av500/bbb_d300_cnc/hardware/bbb_d300_breakout.png

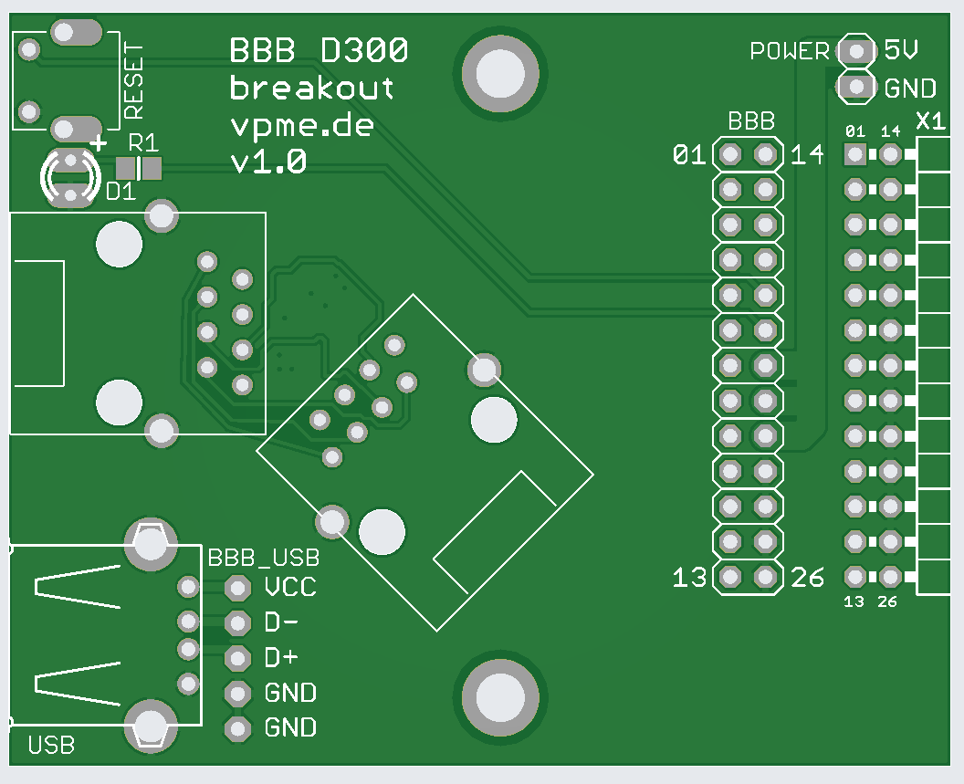
hardware/bbb_d300_breakout.png
