av500/bbb_d300_cnc/hardware/bbb_d300_cape.png

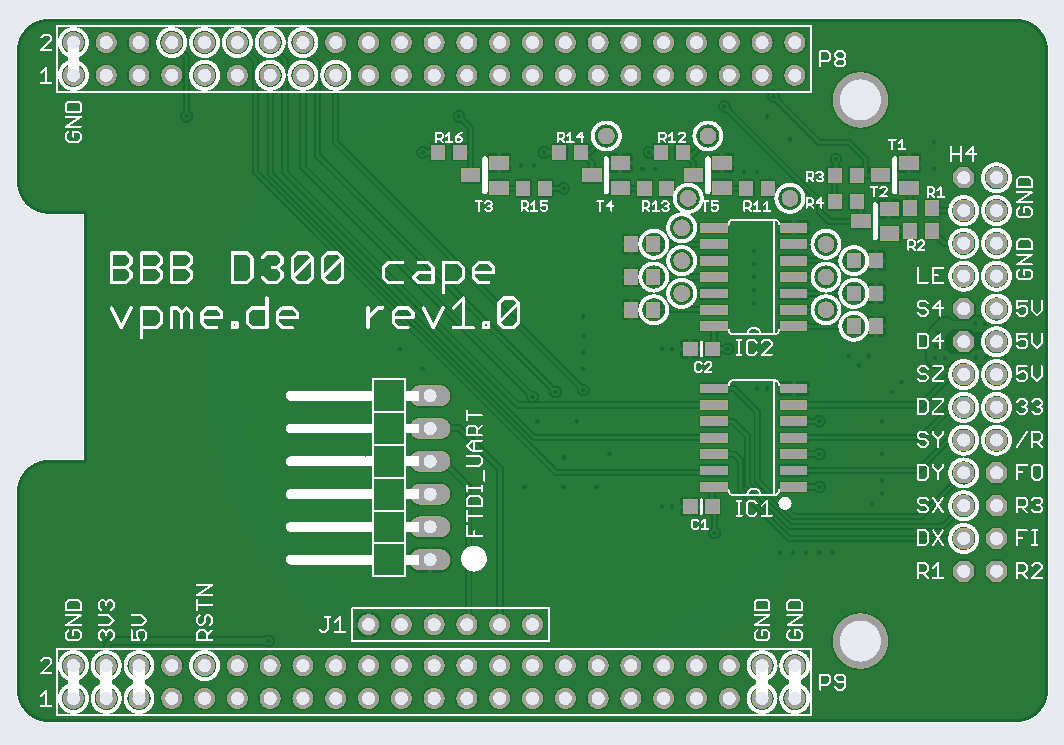
hardware/bbb_d300_cape.png
