av500/bbb_d300_cnc/hardware/sc300_microstep_piano.brd

## EAGLE design hardware/sc300_microstep_piano.brd (2023-05-05)

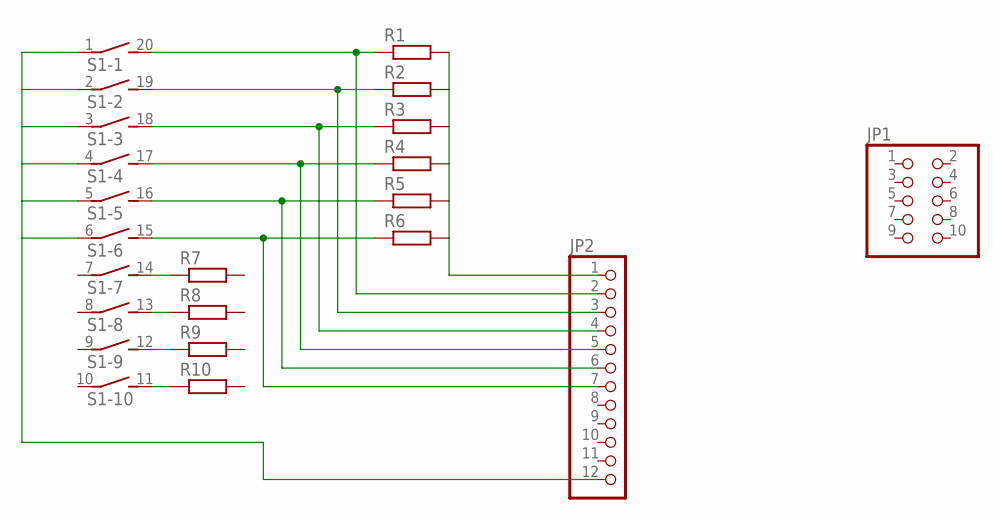
[picture p3: schematic sc300_microstep_piano.sch, sheet 1]

Parts:
JP1: PINHD-2X5; 2X05
JP2: PINHD-1X12; 1X12
R1, R2, R3, R4, R5, R6, R7, R8, R9, R10: R-EU_0603; R0603
S1: DIP10SB

Connections:
GND_SC: JP2.12, S1.1, S1.2 (1), S1.3 (1), S1.4 (1), S1.5 (1), S1.6 (1)
unnamed: R7.1, S1.14 (2)
unnamed: JP2.2, R1.1, S1.20 (2)
unnamed: R8.1, S1.13 (2)
unnamed: JP2.3, R2.1, S1.19 (2)
unnamed: JP2.4, R3.1, S1.18 (2)
unnamed: JP2.5, R4.1, S1.17 (2)
unnamed: JP2.6, R5.1, S1.16 (2)
unnamed: JP2.7, R6.1, S1.15 (2)
unnamed: R9.1, S1.12 (2)
unnamed: R10.1, S1.11 (2)
unnamed: JP2.1, R1.2, R2.2, R3.2, R4.2, R5.2, R6.2

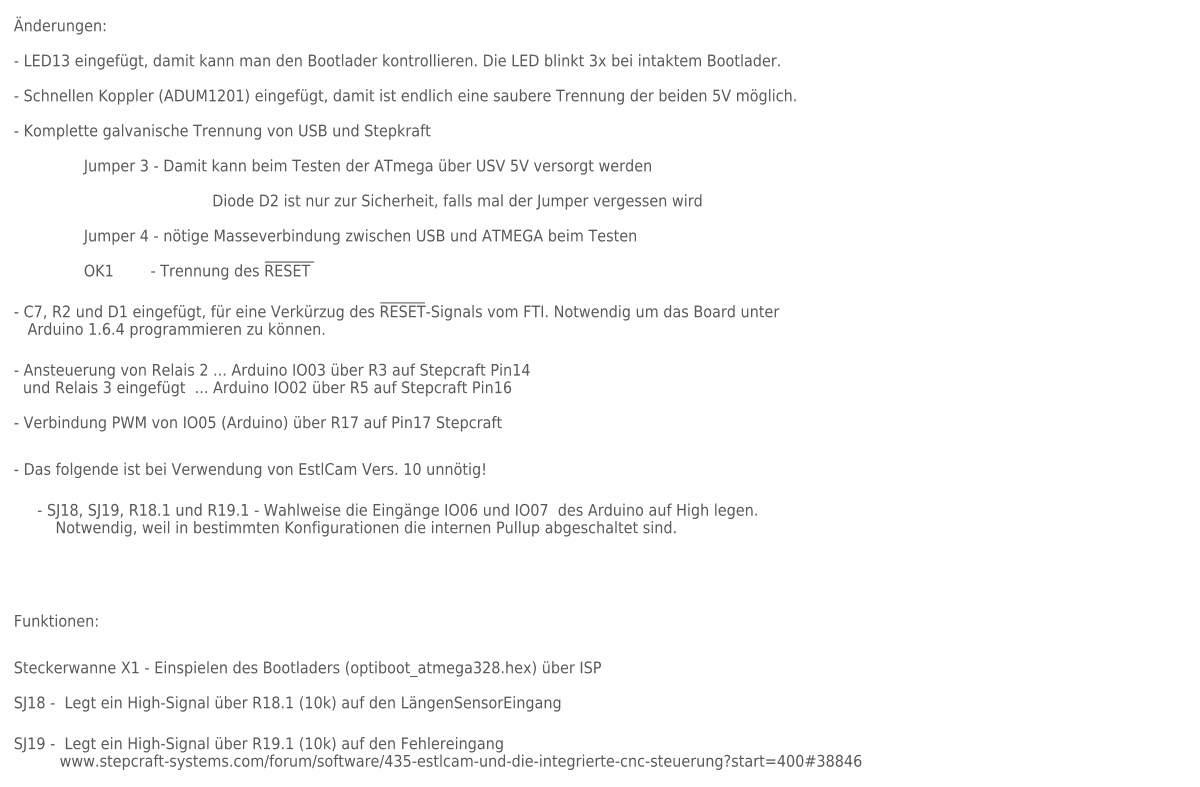
[picture p4: schematic sc300_microstep_piano.sch, sheet 2]

Notes on the sheet:
Änderungen:
- LED13 eingefügt, damit kann man den Bootlader kontrollieren. Die LED blinkt 3x bei intaktem Bootlader.
- Schnellen Koppler (ADUM1201) eingefügt, damit ist endlich eine saubere Trennung der beiden 5V möglich.
Jumper 3 - Damit kann beim Testen der ATmega über USV 5V versorgt werden
Diode D2 ist nur zur Sicherheit, falls mal der Jumper vergessen wird
Funktionen:
Steckerwanne X1 - Einspielen des Bootladers (optiboot_atmega328.hex) über ISP
Jumper 4 - nötige Masseverbindung zwischen USB und ATMEGA beim Testen
- Komplette galvanische Trennung von USB und Stepkraft
- C7, R2 und D1 eingefügt, für eine Verkürzug des !RESET!-Signals vom FTI. Notwendig um das Board unter Arduino 1.6.4 programmieren zu können.
OK1 - Trennung des !RESET
- Ansteuerung von Relais 2 ... Arduino IO03 über R3 auf Stepcraft Pin14 und Relais 3 eingefügt ... Arduino IO02 über R5 auf Stepcraft Pin16
- Verbindung PWM von IO05 (Arduino) über R17 auf Pin17 Stepcraft
SJ19 - Legt ein High-Signal über R19.1 (10k) auf den Fehlereingang www.stepcraft-systems.com/forum/software/435-estlcam-und-die-integrierte-cnc-steuerung?start=400#38846
SJ18 - Legt ein High-Signal über R18.1 (10k) auf den LängenSensorEingang
- SJ18, SJ19, R18.1 und R19.1 - Wahlweise die Eingänge IO06 und IO07 des Arduino auf High legen. Notwendig, weil in bestimmten Konfigurationen die internen Pullup abgeschaltet sind.
- Das folgende ist bei Verwendung von EstlCam Vers. 10 unnötig!

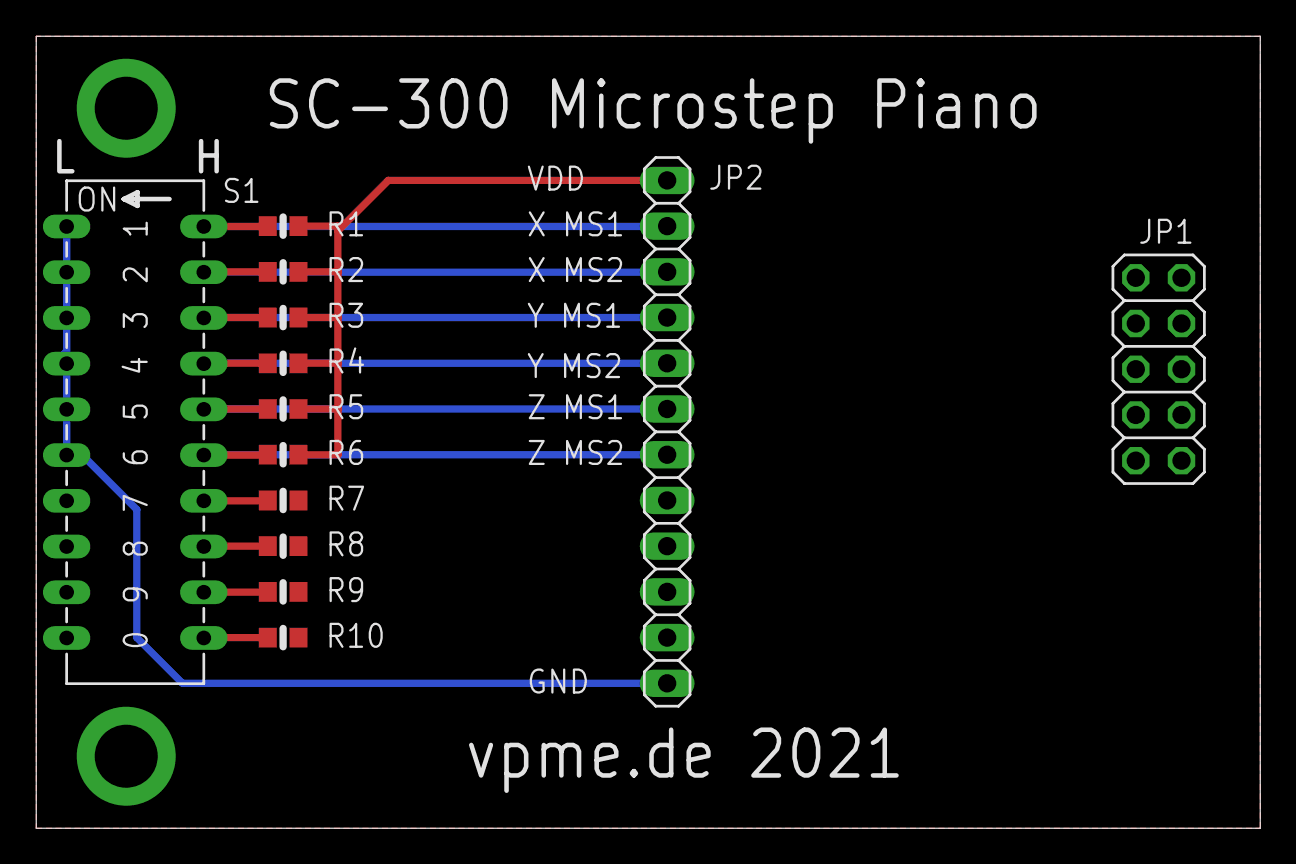
[picture p5: board sc300_microstep_piano.brd from above]

Board: 2 copper layers, 68.0 x 44.0 mm, 13 parts (0 on the bottom side), 12 nets.
