av500/bbb_d300_cnc/hardware/bbb_d300_breakout.brd

## EAGLE design hardware/bbb_d300_breakout.brd (2023-03-31)

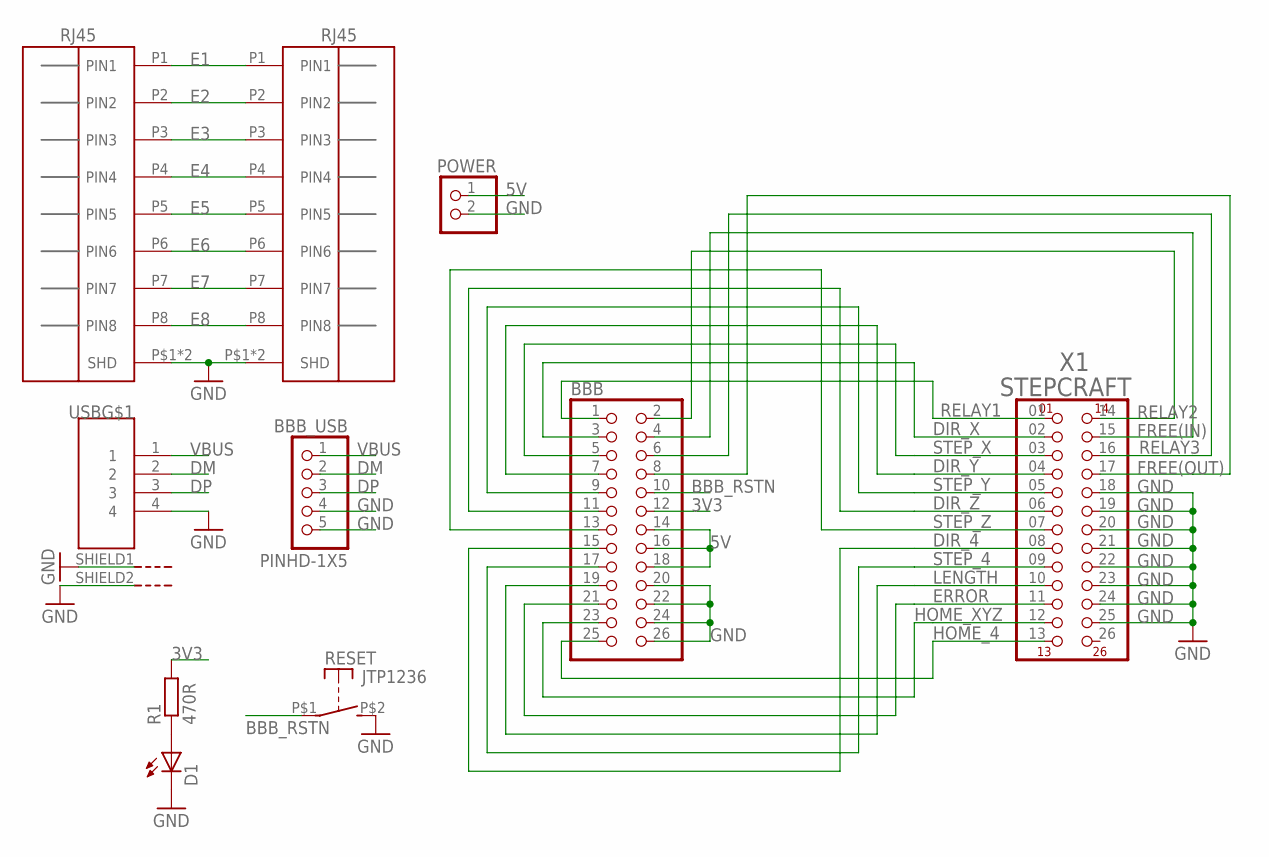
[picture p6: schematic bbb_d300_breakout.sch, sheet 1]

Parts:
BBB: PINHD-2X13; 2X13
BBB_USB: PINHD-1X5; 1X05_XXL
D1: LEDXXL; LED3MM_XXL
POWER: PINHD-1X2; 1X02
R1: 470R; R0805
RESET: JTP1236
USB: USB_HOST; USB
X1: STEPCRAFT; 2X13_90_STEPCRAFT
X2, X3: RJ45

Connections:
3V3: BBB.12, R1.2
5V: BBB.14, BBB.16, BBB.18, POWER.1
BBB_RSTN: BBB.10, RESET.P$1
DIR_4: BBB.15, X1.08 (8)
DIR_X: BBB.3, X1.02 (2)
DIR_Y: BBB.7, X1.04 (4)
DIR_Z: BBB.11, X1.06 (6)
DM: BBB_USB.2, USB.2
DP: BBB_USB.3, USB.3
E1: X2.P1 (PIN1), X3.P1 (PIN1)
E2: X2.P2 (PIN2), X3.P2 (PIN2)
E3: X2.P3 (PIN3), X3.P3 (PIN3)
E4: X2.P4 (PIN4), X3.P4 (PIN4)
E5: X2.P5 (PIN5), X3.P5 (PIN5)
E6: X2.P6 (PIN6), X3.P6 (PIN6)
E7: X2.P7 (PIN7), X3.P7 (PIN7)
E8: X2.P8 (PIN8), X3.P8 (PIN8)
ERROR: BBB.21, X1.11
FREE(IN): BBB.4, X1.15
FREE(OUT): BBB.8, X1.17
GND: BBB.20, BBB.22, BBB.24, BBB.26, BBB_USB.4, BBB_USB.5, D1.K (C), POWER.2, RESET.P$2 (S), USB.4, USB.SHIELD1 (G), USB.SHIELD2 (G), X1.18, X1.19, X1.20, X1.21, X1.22, X1.23, X1.24, X1.25, X2.P$1 (SHD), X2.P$2 (SHD), X3.P$1 (SHD), X3.P$2 (SHD)
HOME_4: BBB.25, X1.13
HOME_XYZ: BBB.23, X1.12
LENGTH: BBB.19, X1.10
unnamed: D1.A, R1.1
RELAY1: BBB.1, X1.01 (1)
RELAY2: BBB.2, X1.14
RELAY3: BBB.6, X1.16
STEP_4: BBB.17, X1.09 (9)
STEP_X: BBB.5, X1.03 (3)
STEP_Y: BBB.9, X1.05 (5)
STEP_Z: BBB.13, X1.07 (7)
VBUS: BBB_USB.1, USB.1


Notes on the sheet:
Änderungen:
- LED13 eingefügt, damit kann man den Bootlader kontrollieren. Die LED blinkt 3x bei intaktem Bootlader.
- Schnellen Koppler (ADUM1201) eingefügt, damit ist endlich eine saubere Trennung der beiden 5V möglich.
Jumper 3 - Damit kann beim Testen der ATmega über USV 5V versorgt werden
Diode D2 ist nur zur Sicherheit, falls mal der Jumper vergessen wird
Funktionen:
Steckerwanne X1 - Einspielen des Bootladers (optiboot_atmega328.hex) über ISP
Jumper 4 - nötige Masseverbindung zwischen USB und ATMEGA beim Testen
- Komplette galvanische Trennung von USB und Stepkraft
- C7, R2 und D1 eingefügt, für eine Verkürzug des !RESET!-Signals vom FTI. Notwendig um das Board unter Arduino 1.6.4 programmieren zu können.
OK1 - Trennung des !RESET
- Ansteuerung von Relais 2 ... Arduino IO03 über R3 auf Stepcraft Pin14 und Relais 3 eingefügt ... Arduino IO02 über R5 auf Stepcraft Pin16
- Verbindung PWM von IO05 (Arduino) über R17 auf Pin17 Stepcraft
SJ19 - Legt ein High-Signal über R19.1 (10k) auf den Fehlereingang www.stepcraft-systems.com/forum/software/435-estlcam-und-die-integrierte-cnc-steuerung?start=400#38846
SJ18 - Legt ein High-Signal über R18.1 (10k) auf den LängenSensorEingang
- SJ18, SJ19, R18.1 und R19.1 - Wahlweise die Eingänge IO06 und IO07 des Arduino auf High legen. Notwendig, weil in bestimmten Konfigurationen die internen Pullup abgeschaltet sind.
- Das folgende ist bei Verwendung von EstlCam Vers. 10 unnötig!

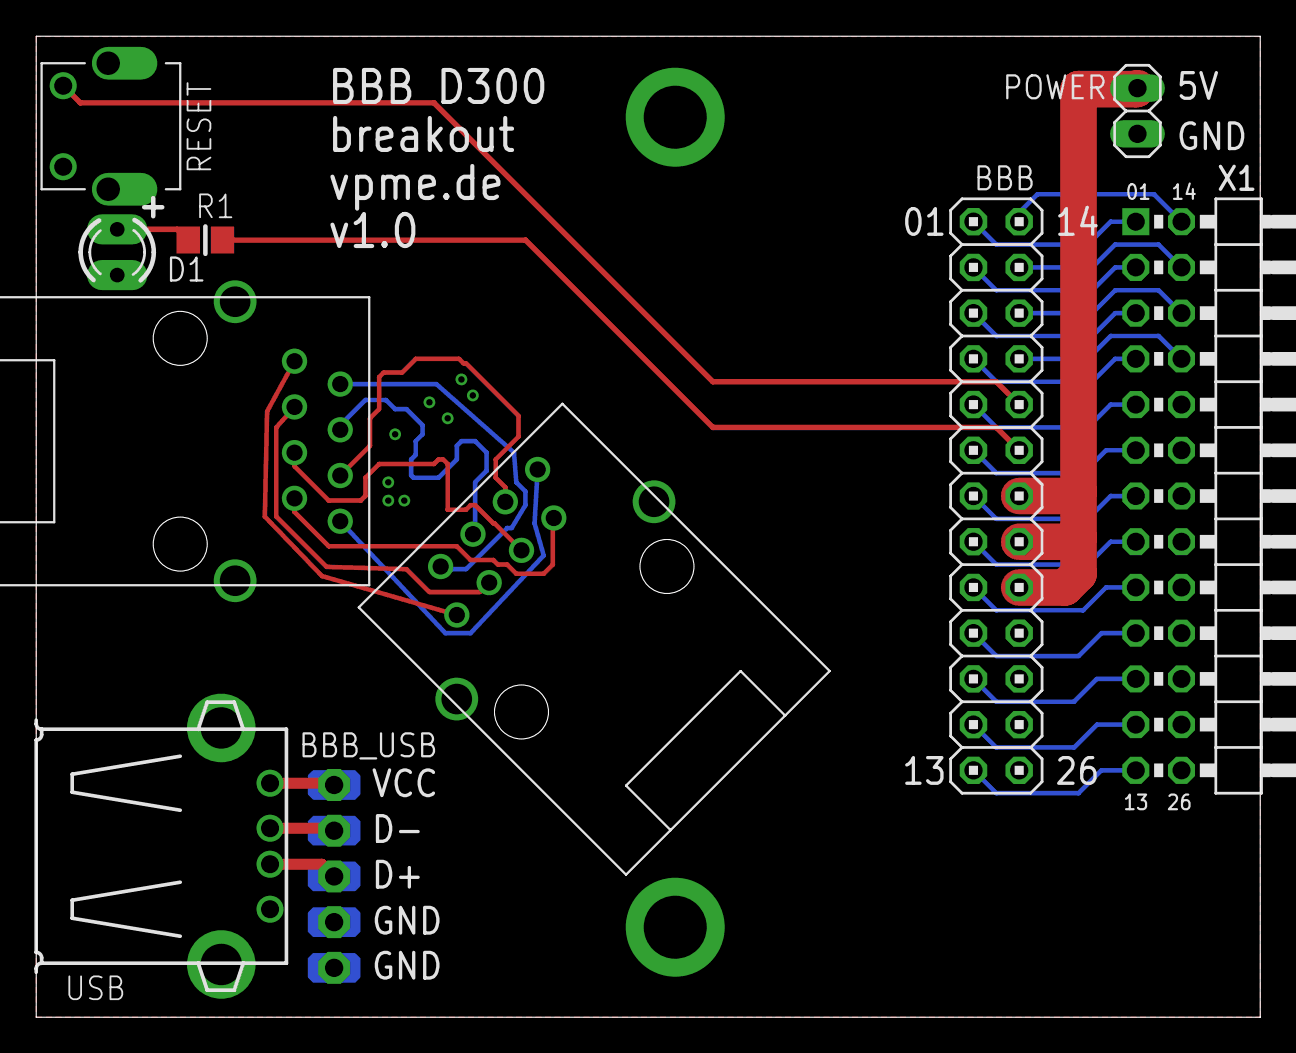
[picture p7: board bbb_d300_breakout.brd from above]

Board: 2 copper layers, 68.0 x 54.5 mm, 10 parts (0 on the bottom side), 33 nets.
