av500/bbb_d300_cnc/hardware/bbb_d300_cape.brd

## EAGLE design hardware/bbb_d300_cape.brd (2023-03-30)

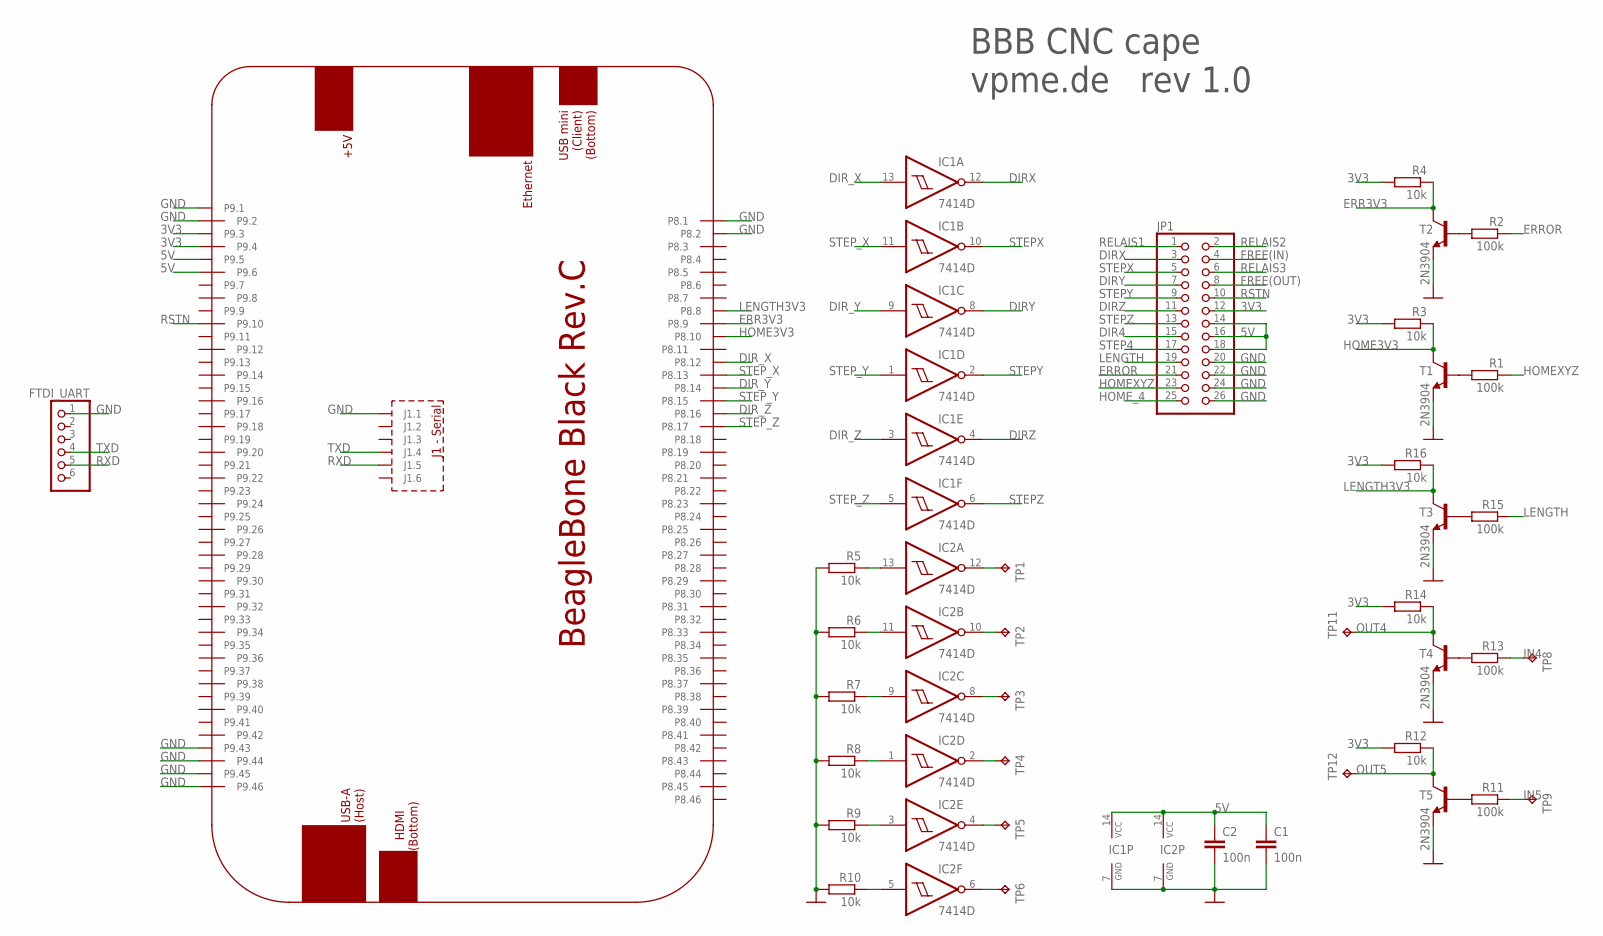
[picture p8: schematic bbb_d300_cape.sch, power süppli]

Parts:
C1, C2: 100n; C0603
FTDI_UART: PINHD-1X6/90; 1X06/90
IC1, IC2: 7414D; SO14
JP1: PINHD-2X13/90; 2X13/90
PCB2: BEAGLEBONE_BLACK_CAPE
R1, R2, R11, R13, R15: 100k; R0603
R3, R4, R5, R6, R7, R8, R9, R10, R12, R14, R16: 10k; R0603
T1, T2, T3, T4, T5: 2N3904; SOT23-BEC
TP1, TP2, TP3, TP4, TP5, TP6, TP8, TP9, TP11, TP12: TPTP12R; TP12R

Connections:
3V3: JP1.12, PCB2.P9.3, PCB2.P9.4, R3.2, R4.2, R12.2, R14.2, R16.2
5V: C1.1, C2.1, IC1.14 (VCC), IC2.14 (VCC), JP1.14, JP1.16, JP1.18, PCB2.P9.5, PCB2.P9.6
DIR4: JP1.15
DIRX: IC1.12 (O), JP1.3
DIRY: IC1.8 (O), JP1.7
DIRZ: IC1.4 (O), JP1.11
DIR_X: IC1.13 (I), PCB2.P8.12
DIR_Y: IC1.9 (I), PCB2.P8.14
DIR_Z: IC1.3 (I), PCB2.P8.16
ERR3V3: PCB2.P8.9, R4.1, T2.C
ERROR: JP1.21, R2.1
FREE(IN): JP1.4
FREE(OUT): JP1.8
GND: C1.2, C2.2, FTDI_UART.1, IC1.7 (GND), IC2.7 (GND), JP1.20, JP1.22, JP1.24, JP1.26, PCB2.J1.1, PCB2.P8.1, PCB2.P8.2, PCB2.P9.1, PCB2.P9.2, PCB2.P9.43, PCB2.P9.44, PCB2.P9.45, PCB2.P9.46, R5.2, R6.2, R7.2, R8.2, R9.2, R10.2, T1.E, T2.E, T3.E, T4.E, T5.E
HOME3V3: PCB2.P8.10, R3.1, T1.C
HOMEXYZ: JP1.23, R1.1
HOME_4: JP1.25
IN4: R13.1, TP8.TP
IN5: R11.1, TP9.TP
LENGTH: JP1.19, R15.1
LENGTH3V3: PCB2.P8.8, R16.1, T3.C
unnamed: IC2.13 (I), R5.1
unnamed: R2.2, T2.B
unnamed: IC2.11 (I), R6.1
unnamed: IC2.9 (I), R7.1
unnamed: IC2.1 (I), R8.1
unnamed: IC2.3 (I), R9.1
unnamed: IC2.5 (I), R10.1
unnamed: IC2.6 (O), TP6.TP
unnamed: IC2.4 (O), TP5.TP
unnamed: IC2.2 (O), TP4.TP
unnamed: IC2.8 (O), TP3.TP
unnamed: IC2.10 (O), TP2.TP
unnamed: IC2.12 (O), TP1.TP
unnamed: R11.2, T5.B
unnamed: R13.2, T4.B
unnamed: R1.2, T1.B
unnamed: R15.2, T3.B
OUT4: R14.1, T4.C, TP11.TP
OUT5: R12.1, T5.C, TP12.TP
RELAIS1: JP1.1
RELAIS2: JP1.2
RELAIS3: JP1.6
RSTN: JP1.10, PCB2.P9.10
RXD: FTDI_UART.5, PCB2.J1.5
STEP4: JP1.17
STEPX: IC1.10 (O), JP1.5
STEPY: IC1.2 (O), JP1.9
STEPZ: IC1.6 (O), JP1.13
STEP_X: IC1.11 (I), PCB2.P8.13
STEP_Y: IC1.1 (I), PCB2.P8.15
STEP_Z: IC1.5 (I), PCB2.P8.17
TXD: FTDI_UART.4, PCB2.J1.4

Notes on the sheet:
BBB CNC cape vpme.de rev 1.0

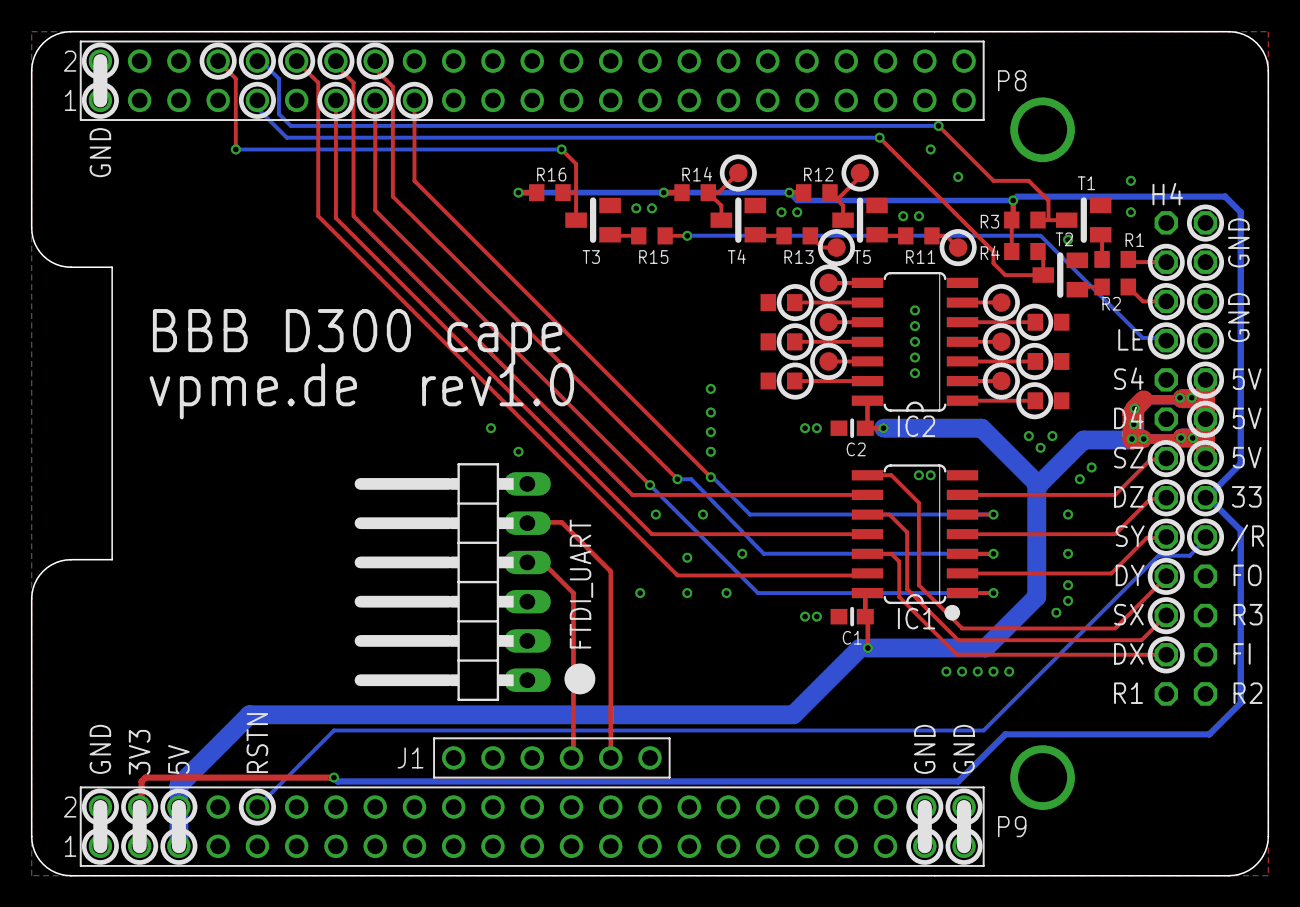
[picture p9: board bbb_d300_cape.brd from above]

Board: 2 copper layers, 80.0 x 54.6 mm, 38 parts (1 on the bottom side), 45 nets.
