av500/bbb_d300_cnc/D300/D300.hal

# These buffer ALL signals used on the DB25 port
# The board also has a pair of a set of four 0805 size jumper resistors
# these can be used to output either the standard Spindle/Mist/flood and
# input ALIM from the DB25 pins
# or allow BBB SPI singnals to be routed to the DB25 connector instead.
# The ALIM RC buffer Capacitor would need to change if this
# option was used.  The LIM Switch input signals are pulled to 3V3 through
# 10K resistors
# then go through a 1K resistor and bypassed with a .22uF cap.   This is
# the cap that should be removed
# if the SPI port (untested option)  is used.  The 4 SPI signals are also
# directly routed
# to six through-holes which include 3V3 and GND.  This signals are
# otherwise Unbuffered and
# go directly to the BBB
# At powerup the LVC541 enable signals are pulled high, disabling the
# drivers until
# the BBB and Machinekit pull the enable signal low.
########################################

# Launch the setup script to make sure hardware setup looks good
loadusr -w ./D300_setup.sh

# ###################################
# Core EMC/HAL Loads
# ###################################

# kinematics
loadrt trivkins

# motion controller, get name and thread periods from ini file
# trajectory planner
loadrt tp
loadrt [EMCMOT]EMCMOT servo_period_nsec=[EMCMOT]SERVO_PERIOD num_joints=[TRAJ]AXES tp=tp kins=trivkins


# load low-level drivers
loadrt hal_bb_gpio output_pins=107 input_pins=108,109,110
loadrt [PRUCONF](DRIVER) prucode=$(HAL_RTMOD_DIR)/[PRUCONF](PRUBIN) [PRUCONF](CONFIG) halname=hpg
#(JP) Not suing PID loop so comment out
loadrt pid count=3
loadrt limit1 count=2

# ################################################
# THREADS
# ################################################

addf hpg.capture-position                 servo-thread
addf bb_gpio.read                         servo-thread
addf motion-command-handler               servo-thread
addf motion-controller                    servo-thread
#(JP) Not doing PID for temperature sensor for PWM output
addf pid.0.do-pid-calcs                   servo-thread
addf pid.1.do-pid-calcs                   servo-thread
addf pid.2.do-pid-calcs                   servo-thread
addf limit1.0                             servo-thread
addf limit1.1                             servo-thread
addf hpg.update                           servo-thread
addf bb_gpio.write                        servo-thread

# ######################################################
# Axis-of-motion Specific Configs (not the GUI)
# ######################################################
net all-home <= bb_gpio.p8.in-10
setp bb_gpio.p8.in-10.invert 1

# ################
# X [0] Axis
# ################

# axis enable chain
newsig emcmot.00.enable bit
sets emcmot.00.enable FALSE

net emcmot.00.enable <= axis.0.amp-enable-out
net emcmot.00.enable => hpg.stepgen.00.enable pid.0.enable

# position command and feedback
net emcmot.00.pos-cmd axis.0.motor-pos-cmd => pid.0.command
net emcmot.00.vel-cmd axis.0.joint-vel-cmd => pid.0.command-deriv
net motor.00.pos-fb <= hpg.stepgen.00.position-fb axis.0.motor-pos-fb pid.0.feedback
net motor.00.command pid.0.output hpg.stepgen.00.velocity-cmd
setp pid.0.error-previous-target true
setp pid.0.maxerror .001

# timing parameters
setp hpg.stepgen.00.dirsetup        [AXIS_0]DIRSETUP
setp hpg.stepgen.00.dirhold         [AXIS_0]DIRHOLD

setp hpg.stepgen.00.steplen         [AXIS_0]STEPLEN
setp hpg.stepgen.00.stepspace       [AXIS_0]STEPSPACE

setp hpg.stepgen.00.position-scale  [AXIS_0]SCALE

setp hpg.stepgen.00.maxvel          [AXIS_0]STEPGEN_MAX_VEL
setp hpg.stepgen.00.maxaccel        [AXIS_0]STEPGEN_MAX_ACC

setp hpg.stepgen.00.control-type    1
setp hpg.stepgen.00.stepinvert      [AXIS_0]STEP_INVERT
#setp hpg.stepgen.00.step_type       0
setp hpg.stepgen.00.steppin         813
setp hpg.stepgen.00.dirpin          812

# set PID loop gains from inifile
setp pid.0.Pgain [AXIS_0]P
setp pid.0.Igain [AXIS_0]I
setp pid.0.Dgain [AXIS_0]D
setp pid.0.bias [AXIS_0]BIAS
setp pid.0.FF0 [AXIS_0]FF0
setp pid.0.FF1 [AXIS_0]FF1
setp pid.0.FF2 [AXIS_0]FF2
setp pid.0.deadband [AXIS_0]DEADBAND
setp pid.0.maxoutput [AXIS_0]MAX_OUTPUT

net all-home => axis.0.home-sw-in

# ################
# Y [1] Axis
# ################

# axis enable chain
newsig emcmot.01.enable bit
sets emcmot.01.enable FALSE

net emcmot.01.enable <= axis.1.amp-enable-out
net emcmot.01.enable => hpg.stepgen.01.enable pid.1.enable

# position command and feedback
net emcmot.01.pos-cmd axis.1.motor-pos-cmd => pid.1.command
net emcmot.01.vel-cmd axis.1.joint-vel-cmd => pid.1.command-deriv
net motor.01.pos-fb <= hpg.stepgen.01.position-fb axis.1.motor-pos-fb pid.1.feedback
net motor.01.command pid.1.output hpg.stepgen.01.velocity-cmd
setp pid.1.error-previous-target true
setp pid.1.maxerror .001

# timing parameters
setp hpg.stepgen.01.dirsetup        [AXIS_1]DIRSETUP
setp hpg.stepgen.01.dirhold         [AXIS_1]DIRHOLD

setp hpg.stepgen.01.steplen         [AXIS_1]STEPLEN
setp hpg.stepgen.01.stepspace       [AXIS_1]STEPSPACE

setp hpg.stepgen.01.position-scale  [AXIS_1]SCALE

setp hpg.stepgen.01.maxvel          [AXIS_1]STEPGEN_MAX_VEL
setp hpg.stepgen.01.maxaccel        [AXIS_1]STEPGEN_MAX_ACC

setp hpg.stepgen.01.control-type    1
setp hpg.stepgen.01.stepinvert      [AXIS_1]STEP_INVERT
#setp hpg.stepgen.01.step_type       0
setp hpg.stepgen.01.steppin         815
setp hpg.stepgen.01.dirpin          814

# set PID loop gains from inifile
setp pid.1.Pgain [AXIS_1]P
setp pid.1.Igain [AXIS_1]I
setp pid.1.Dgain [AXIS_1]D
setp pid.1.bias [AXIS_1]BIAS
setp pid.1.FF0 [AXIS_1]FF0
setp pid.1.FF1 [AXIS_1]FF1
setp pid.1.FF2 [AXIS_1]FF2
setp pid.1.deadband [AXIS_1]DEADBAND
setp pid.1.maxoutput [AXIS_1]MAX_OUTPUT

net all-home => axis.1.home-sw-in

# ################
# Z [2] Axis
# ################

# axis enable chain
newsig emcmot.02.enable bit
sets emcmot.02.enable FALSE

net emcmot.02.enable <= axis.2.amp-enable-out
net emcmot.02.enable => hpg.stepgen.02.enable pid.2.enable

# position command and feedback
net emcmot.02.pos-cmd axis.2.motor-pos-cmd => pid.2.command
net emcmot.02.vel-cmd axis.2.joint-vel-cmd => pid.2.command-deriv
net motor.02.pos-fb <= hpg.stepgen.02.position-fb axis.2.motor-pos-fb pid.2.feedback
net motor.02.command pid.2.output hpg.stepgen.02.velocity-cmd
setp pid.2.error-previous-target true
setp pid.2.maxerror .001

# timing parameters
setp hpg.stepgen.02.dirsetup        [AXIS_2]DIRSETUP
setp hpg.stepgen.02.dirhold         [AXIS_2]DIRHOLD

setp hpg.stepgen.02.steplen         [AXIS_2]STEPLEN
setp hpg.stepgen.02.stepspace       [AXIS_2]STEPSPACE

setp hpg.stepgen.02.position-scale  [AXIS_2]SCALE

setp hpg.stepgen.02.maxvel          [AXIS_2]STEPGEN_MAX_VEL
setp hpg.stepgen.02.maxaccel        [AXIS_2]STEPGEN_MAX_ACC

setp hpg.stepgen.02.control-type    1
setp hpg.stepgen.02.stepinvert      [AXIS_2]STEP_INVERT
#setp hpg.stepgen.02.step_type       0
setp hpg.stepgen.02.steppin         817
setp hpg.stepgen.02.dirpin          816

# set PID loop gains from inifile
setp pid.2.Pgain [AXIS_2]P
setp pid.2.Igain [AXIS_2]I
setp pid.2.Dgain [AXIS_2]D
setp pid.2.bias [AXIS_2]BIAS
setp pid.2.FF0 [AXIS_2]FF0
setp pid.2.FF1 [AXIS_2]FF1
setp pid.2.FF2 [AXIS_2]FF2
setp pid.2.deadband [AXIS_2]DEADBAND
setp pid.2.maxoutput [AXIS_2]MAX_OUTPUT

net all-home => axis.2.home-sw-in

# ##################################################
# Standard I/O - EStop, Enables, Limit Switches, Etc
# ##################################################

# Axis enable and IO control enable signals are all on one pin P8-7 which
# goes to DB25-1
# and is used to place the LVC541 drivers on the interface board in active
# (LOW) or unactive (HIGH) state
# All external Inputs and Outputs on external boards
# should have pullups/downs since when the interface board is
# not enabled, it will look disconnected for all signals

# this pin is output on DB25-1
# it is also used to enable the LVC541 driver/receiver on the interface board
net machine-on bb_gpio.p8.out-07 => halui.machine.is-on
setp bb_gpio.p8.out-07.invert 1

#probe input
net probe motion.probe-input <= bb_gpio.p8.in-08
#setp bb_gpio.p8.in-08.invert 1

# this input signal must be active LOW to allow the system to energize.
# this should be fed through an NC STOP type switch from DB25-1 to DB25-10
net estop-in bb_gpio.p8.in-09 => iocontrol.0.emc-enable-in
#setp bb_gpio.p8.in-09.invert 1

loadusr -W hal_manualtoolchange
net tool-change iocontrol.0.tool-change => hal_manualtoolchange.change
net tool-changed iocontrol.0.tool-changed <= hal_manualtoolchange.changed
net tool-number iocontrol.0.tool-prep-number => hal_manualtoolchange.number
net tool-prepare-loopback iocontrol.0.tool-prepare => iocontrol.0.tool-prepared
