av500/bbb_d300_cnc/(commit log)

2023-03-30 add hardware files
    [USB_pcb_breakout.brd, USB_pcb_breakout.sch, bbb_d300_breakout.brd, bbb_d300_breakout.sch, bbb_d300_cape.brd, bbb_d300_cape.sch]
2023-03-30 add the Stepcraft D300 machinekit config (work in progress)
    [D300.hal, ShuttleXpress.postgui.hal, shuttlexpress.hal]
2023-03-30 swap USB and ETH position
    [bbb_d300_breakout.brd, bbb_d300_breakout.sch]
2023-03-30 - add tool probing on P811 - fix tool change freeze
    [D300.hal]
2023-03-30 add pinmux for P8 pin 11
2023-03-30 dont track pru-stepper.var in git
2023-03-30 connect tool length to P8.08
    [bbb_d300_cape.brd, bbb_d300_cape.sch]
2023-03-30 update the gerbers
2023-03-30 add images of PCBs
2023-03-31 add buttons for tool touch off and three place holder for other actions
2023-03-31 edit footprint of RJ45
    [bbb_d300_breakout.brd, bbb_d300_breakout.sch]
2023-05-05 add a board that allows to select the microsteps with DIP switches (some soldering required...)
    [sc300_microstep_piano.brd, sc300_microstep_piano.sch]
